esther091/IoT-based-Predictive-Maintenace-of-Li-ion-Batteries-using-Machine-Learning/docs/main_py_Explained.docx

main.py Explained

A line-by-line guide to the backend of the Battery Health Monitor

File: backend/main.py (460 lines) • For: Mgbedo C. E. and Tarurhor J. O.

How to use this guide

Open backend/main.py in VS Code next to this document. Section 1 explains the Python building blocks you will see everywhere (def, if, @decorators, global, class, try). Section 2 walks through the file from top to bottom, quoting the code with its line numbers. Section 3 follows one reading on its journey through the code, and Section 4 lists the possible results of a discharge.

# What main.py does

main.py is the brain of the system. It runs on the laptop as a small web server (the “backend”) and has four jobs:

1. Receive every reading the ESP32 sends (every 5 seconds) and store it in the database.
2. Detect when a discharge starts and ends, collecting the readings in between.
3. Decide whether the finished discharge is valid and, if so, ask the ML models for SOH and RUL.
4. Answer the dashboard’s questions (latest reading, history, predictions, status).

It never talks to the hardware directly. The ESP32 sends it data over WiFi, and the dashboard asks it for data, both using ordinary web requests (HTTP).

# 1. The Python building blocks you will see

## Comments and docstrings

Anything after # is a comment: a note for humans that Python ignores. Text between triple quotes """ ... """ at the top of a file or function is a docstring, a longer description of what that file or function does.

# Rated capacity of ONE cell. <- comment

def charge_mah(buf):

"""Trapezoidal integral of |current|...""" <- docstring

## import – borrowing tools from other files

import brings in code written elsewhere so this file can use it. For example from fastapi import FastAPI borrows the FastAPI tool that turns Python functions into a web server.

## Variables and constants

A variable is a named box that holds a value: is_discharging = False. By convention, names written in CAPITALS are constants: settings that should not change while the program runs, such as DISCHARGE_THRESHOLD = -0.5. Keeping them at the top makes them easy to find and adjust.

## def – defining a function

def creates a function: a named, reusable block of steps. The names in brackets are its inputs (parameters); return sends a result back. A function does nothing until something calls it by name.

def charge_mah(buf): # define a function with one input, buf

... # the steps

return total / 3.6 # the answer it gives back

capacity_mah = charge_mah(buf) # call it and store the answer

Indentation (the spaces at the start of a line) is how Python knows which lines belong to the function. Everything indented under def is part of it.

## if / elif / else – making decisions

if runs its indented lines only when a condition is true. elif (“else if”) checks another condition, and else runs when none of the above were true. Only one branch runs.

if interrupted: # first check

level = "INTERRUPTED"

elif not started_full: # only checked if the first was false

level = "NOT_STARTED_FULL"

else: # none of the above

level = "PARTIAL_DISCHARGE"

Conditions use comparisons like < (less than), <= (less than or equal), >=, == (equal), and words like and, or, not.

## Lists, dictionaries and loops

- A list is an ordered collection: [3.9, 3.8, 3.7]. discharge_buffer is a list of readings.
- A dictionary stores named values: {"voltage": 3.9, "current": -1.4}. Each buffered reading is a dictionary, read with r["voltage"].
- A list comprehension builds a list in one line: voltages = [r["voltage"] for r in buf] means “take the voltage from every reading in buf”.
- sum(...), min(...), max(...), len(...) add up, find the smallest, the largest, and count.

## class – describing a kind of object

A class is a template. In main.py the classes describe the shape of data, for example class ReadingInput(BaseModel) says a reading must have a voltage, current, power and energy, each a number. This uses a library called Pydantic, which automatically checks incoming data against the template and rejects anything that does not fit.

## @decorators – labels that add behaviour

A line starting with @ directly above a def is a decorator. It wraps the function with extra behaviour without changing the function’s own code. Think of it as a label that tells a library what to do with the function. The decorators in main.py:

Decorator | What it means
@app.post("/readings") | “When a POST request arrives at the address /readings, run the function below.” This is how the ESP32’s readings reach receive_reading.
@app.get("/latest") (and /history, /predictions, /health) | “When a GET request arrives at this address, run the function below and send back what it returns.” The dashboard uses these.
@field_validator("voltage") | Pydantic: “run this function to check and tidy the voltage field of every incoming reading.”
@classmethod | Python: the function belongs to the class itself, not to one object. Pydantic requires it on validators.
@asynccontextmanager | Turns lifespan into a start-up/shut-down routine (explained in section 2.2).

## global – changing a shared variable

Variables created at the top of the file (like is_discharging, discharge_buffer, cycle_counter) are shared by all functions. A function can read them freely, but to change one it must say global name first. Without that line, Python would create a separate local copy and the change would be lost when the function ends.

## try / except / finally – handling errors safely

try runs code that might fail. If an error happens, Python jumps to except instead of crashing. finally runs no matter what – perfect for clean-up such as emptying the buffer or closing the database.

try:

...save the cycle and prediction...

except Exception as e:

db.rollback() # undo half-finished database changes

print(f"Error ... {e}")

finally:

discharge_buffer = [] # always start the next discharge empty

## Other small things

- None means “no value” – e.g. a prediction’s SOH is None when no prediction was made.
- True / False are yes / no values (booleans).
- f"...{x}..." is an f-string: text with values inserted, e.g. f"Cycle {cycle_counter} complete". {x:.2f} shows x with 2 decimal places.
- print(...) writes a message in the backend window – this is where you see “Discharge started”, “Cycle 1 complete …” and safety warnings.
- async / yield appear only in lifespan; you do not need them anywhere else in this file.

# 2. The file from top to bottom

## 2.1 Lines 1–20: description and imports

Lines 1–6 are the file’s docstring. Lines 8–20 import the tools it needs:

Import | What it is used for
FastAPI, Depends, HTTPException | Build the web server, hand each request a database session, and report errors.
CORSMiddleware | Allow the dashboard (a different program/port) to call this server.
BaseModel, Field, field_validator, ConfigDict | Pydantic: describe and check the data shapes.
Session, func | SQLAlchemy: talk to the SQLite database; func.max finds the highest cycle number.
datetime, timezone, time | Time stamps (UTC) and the laptop clock in seconds.
List, Optional | Type hints: “a list of …”, “… or None”.
uvicorn | The program that actually runs the web server on port 8000.
from database import ... | Our own database.py: the tables Reading, Cycle, Prediction and session helpers.
from ml_inference import inference | Our own ml_inference.py: the loaded models and their predict() function.

## 2.2 Lines 26–46: lifespan – what happens at start-up

@asynccontextmanager

async def lifespan(app: FastAPI):

global cycle_counter

create_tables() # make sure the database tables exist

inference.load_models() # load the 5 .pkl model files

...find the highest cycle number already in the database...

yield # <- the server runs here, receiving requests

print("Backend shutting down.")

Everything before yield runs once when the backend starts: it prepares the database, loads the machine-learning models (you see “All ML models loaded successfully.”) and recovers the cycle count so numbering continues after a restart. The server then runs at yield until it is closed; the line after yield runs on shut-down.

## 2.3 Lines 49–61: creating the app

app = FastAPI(...) creates the web server object and attaches the lifespan routine. app.add_middleware(CORSMiddleware, allow_origins=["*"], ...) lets any page (in practice, the Streamlit dashboard) call it. Every @app.get / @app.post decorator later in the file registers a function with this app.

## 2.4 Lines 63–93: shared state and settings

Shared state – variables that remember what is happening between readings:

Variable | Meaning
discharge_buffer = [] | The readings collected during the current discharge.
is_discharging = False | Are we in the middle of a discharge right now?
cycle_start_time = None | When the current discharge began.
cycle_counter = 0 | How many discharges have been processed (gives each cycle its number).
last_rx_wall = None | Laptop clock time of the last reading received – used to notice when readings stop.
rest_peak_v = None | Highest resting (no-load) voltage per cell seen while idle – the evidence that the cells were charged.
discharge_rest_v = None | The resting voltage captured when the current discharge started.
load_off_since = None | When the load current first dropped away mid-discharge – used to ignore short dropouts.

Settings (constants) – the numbers that control the decisions:

Constant | Value | Meaning
DISCHARGE_THRESHOLD | −0.5 A | Current below this = discharging. The −0.5 margin ignores sensor noise around 0 A.
RATED_CAPACITY_MAH | 2000 | Capacity of one new cell. Measured SOH = mAh delivered ÷ 2000 × 100.
FULL_DISCHARGE_MAX_CELL_V | 3.2 V | The discharge must reach this per-cell voltage (or lower) to count as complete.
FULL_START_MIN_CELL_V | 3.99 V | The RESTING voltage per cell before the load went on must be at least this – i.e. the cells were charged.
FULL_START_MAX_CELL_V | 4.5 V | …and not above this (a higher value would be an impossible reading).
LOAD_OFF_CONFIRM_SECONDS | 30 s | The load must stay off this long to end a discharge, so a brief contact dropout does not split one run in two.
LOW_CELL_ALARM_V | 2.8 V | Below this, a “SWITCH THE LOAD OFF NOW” warning is printed and shown.
BMS_CUTOFF_WAIT_SECONDS | 30 s | Silence this long after reaching 3.2 V = the BMS has cut off → discharge complete.
STALE_SECONDS | 180 s | Silence this long in the middle of a discharge = interrupted → no prediction.

## 2.5 Lines 96–101: charge_mah() – counting the charge delivered

def charge_mah(buf):

return sum(

(abs(buf[k]["current"]) + abs(buf[k - 1]["current"])) / 2

* max(0.0, buf[k]["t"] - buf[k - 1]["t"])

for k in range(1, len(buf))

) / 3.6

This adds up current × time across the discharge (the trapezoidal rule). For each pair of neighbouring readings it takes their average current and multiplies by the seconds between them, giving amp-seconds. Dividing the total by 3.6 converts amp-seconds into milliamp-hours (mAh). Example: 1.4 A for 60 minutes → 1.4 × 3600 ÷ 3.6 = 1400 mAh. This is the number behind the dashboard’s “Charge delivered” and “Measured SOH”.

## 2.6 Lines 107–183: the data shapes (Pydantic schemas)

Each class describes data coming in or going out.

ReadingInput (lines 107–136) is the shape every ESP32 reading must have. Field(..., gt=0, lt=350) means “required, greater than 0 and less than 350”. If a reading breaks a rule, FastAPI automatically rejects it with error 422 and the code below never sees it. The four @field_validator functions tidy each value: voltage_check rejects voltages below 0.05 V (“check PZEM-017 connections”) and rounds to 3 decimals; the others round current, power and energy.

ReadingOut, PredictionOut, CycleOut, LatestOut (lines 139–183) describe what is sent back to the dashboard. model_config = ConfigDict(from_attributes=True) lets Pydantic build them straight from database rows. Optional[float] means “a number, or None” – SOH is None when no prediction was made. CycleOut.measured_soh is filled in by /latest.

## 2.7 Lines 186–296: process_discharge_cycle() – the heart of the file

Called once when a discharge ends. It turns the buffered readings into one cycle and, if the cycle is valid, a prediction. Step by step:

1. Too short? (lines 192–194) Fewer than 3 readings is a blip, not a discharge: empty the buffer and stop.
2. Sort the readings by device time (line 198), in case some arrived late from the ESP32’s memory.
3. Compute the four model inputs (lines 199–216), exactly as in training: mean voltage, mean |current| (always positive), mean power, and energy delivered in Wh (V × |I| × time, trapezoidal rule ÷ 3600).
4. Measure and check (lines 218–226): capacity_mah via charge_mah(); min_cell_voltage (did it reach empty?); start_cell_voltage = the resting voltage recorded before the load went on (if none was received, the highest of the first 6 readings). Then complete = reached ≤ 3.2 V **and** started at 3.99–4.5 V **and** not interrupted.
5. Save the cycle (lines 228–243): increase cycle_counter and add a Cycle row with the features, mAh, minimum voltage and the complete flag.
6. Predict or explain (lines 245–258): if complete, call inference.predict(...) – this is where Random Forest and XGBoost produce SOH, RUL and the alert level. Otherwise create an empty result whose alert_level says why: INTERRUPTED, NOT_STARTED_FULL or PARTIAL_DISCHARGE.
7. Save the prediction (lines 260–271) as a Prediction row and commit (make the database changes permanent).
8. Print a summary in the backend window (lines 273–288), e.g. “Cycle 3 complete -- SOH: 92.1% … delivered 1840 mAh (measured SOH 92.0%)”.
9. If anything failed (lines 290–293): undo the database changes and the cycle number. Always (lines 295–296): empty the buffer for the next discharge.

The interrupted=False and start_rest_v=None in the first line are default values: callers can leave them out. interrupted is only True when close_if_stale() decides the readings stopped too early, and start_rest_v carries the resting voltage measured before the load went on.

## 2.8 Lines 302–367: receive_reading() – the /readings address

@app.post("/readings") makes this run for every reading the ESP32 sends. data: ReadingInput means FastAPI has already checked the reading against the ReadingInput shape. db: Session = Depends(get_db) means FastAPI opens a database session for this request and closes it afterwards.

1. Check for a stale discharge first (line 309): if readings had stopped for too long, close that old run before handling the new reading – so a new test is never glued onto a broken one. Then note the time (line 310).
2. Store the reading in the readings table (lines 312–324). If saving fails, reply with error 500.
3. Make a small dictionary of the reading for the buffer (lines 326–334). The time t comes from the ESP32’s own clock (milliseconds ÷ 1000), so readings cached during a WiFi drop keep their real spacing.
4. Safety check (lines 336–338): discharging and below 2.8 V per cell → print the SWITCH OFF warning.
5. The discharge detector (lines 340–365) – a small “state machine”:
  - Current below −0.5 A and not already discharging → a discharge has started: set is_discharging = True, note the start time, empty the buffer, and keep the resting voltage seen just before (discharge_rest_v). Every discharging reading is then appended to the buffer.
  - Current back above −0.5 A while discharging → the load may be off: note the time in load_off_since. Only if it stays off for 30 s does end_discharge(db) close the run; if current returns sooner (a loose contact), the same discharge simply continues. With no load at all, each reading updates rest_peak_v, the resting voltage.
6. Reply {"status": "ok", "id": ...} so the ESP32 knows the reading arrived (line 367).

## 2.9 Lines 370–392: the dashboard’s read-only addresses

Address | Function | What it returns
GET /latest | get_latest | The newest reading, newest prediction and newest cycle (plus measured SOH = mAh ÷ 2000 × 100). Feeds the cards, gauge, banners and result row.
GET /history?limit=100 | get_history | The last 100 readings, oldest first. Feeds the four charts and the Raw Readings table.
GET /predictions | get_predictions | Every prediction ever made, oldest first.

response_model=LatestOut (etc.) tells FastAPI to shape the reply using that Pydantic class. .order_by(Reading.id.desc()).first() means “sort newest first and take the first one”.

## 2.10 Lines 394–432: end_discharge() and close_if_stale() – when a run ends

On the rig, the PZEM-017 gets its power through the BMS output, so when the BMS cuts off at the end of a discharge the PZEM goes silent and the final “0 A” reading never arrives. This function handles that:

if load off for 30 s: # load switched off and stayed off

end_discharge(db) # -> closes the run normally

silent = time.time() - last_rx_wall # seconds since the last reading

reached_end = min(voltages in buffer) <= 3.2 # had the pack reached empty?

if reached_end and silent > 30: # BMS cut-off

process_discharge_cycle(db) # -> complete, predict

elif silent > 180: # stopped too early

process_discharge_cycle(db, interrupted=True) # -> INTERRUPTED, no prediction

It is called both when a new reading arrives and every time the dashboard checks /health (every 5 s), so a cut-off is noticed even though no more readings come.

## 2.11 Lines 434–457: health_check() – the /health address

Called by the dashboard every 5 seconds. It first runs close_if_stale() (with its own database session, opened and closed with try/finally), then returns the live status: seconds since the last reading, whether models are loaded, whether a discharge is running, the cycle count, and the live progress (discharge_mah, discharge_minutes) shown in the blue “Discharging …” banner.

## 2.12 Lines 459–460: starting the server

if __name__ == "__main__":

uvicorn.run("main:app", host="0.0.0.0", port=8000, reload=False)

if __name__ == "__main__": is true only when the file is run directly (python main.py, which start_system.bat does). It starts the server on port 8000, listening on all network addresses (0.0.0.0) so the ESP32 on the WiFi can reach it.

# 3. One reading’s journey

1. The ESP32 sends {"voltage": 3.95, "current": -1.42, "power": 5.6, "energy": 0.3, "timestamp": 812345} to http://<laptop-IP>:8000/readings.
2. FastAPI checks it against ReadingInput (all numbers in range? voltage ≥ 0.05?). If not → error 422.
3. receive_reading() runs: checks for a stale run, saves the reading to the database, adds it to the buffer (current is below −0.5 A, so it is part of a discharge).
4. Five seconds later the dashboard calls /latest, /history and /health and shows the new values.
5. About 80 minutes later the BMS cuts off. Readings stop. Within ~30 s close_if_stale() (via /health) sees the pack had reached ≤ 3.2 V and calls process_discharge_cycle().
6. The resting voltage before the load was 3.99–4.5 V and the pack reached ≤ 3.2 V → complete → inference.predict() → SOH, RUL, alert saved → shown on the dashboard.

# 4. How a discharge is classified

Result (alert_level) | When | Prediction? | Dashboard banner
NORMAL / WARNING / CRITICAL / URGENT | Rested at 3.99–4.5 V/cell before the load, reached ≤ 3.2 V/cell, not interrupted | Yes | Coloured alert + SOH gauge, RUL, result row
NOT_STARTED_FULL | Resting voltage before the load outside 3.99–4.5 V/cell (cells not charged) | No | Did not start from a full pack
PARTIAL_DISCHARGE | Started full, but the load was switched off (for 30 s or more) before 3.2 V/cell | No | Partial discharge
INTERRUPTED | Readings stopped for 3 min before reaching 3.2 V/cell | No | Discharge interrupted
(fewer than 3 readings) | A blip, not a discharge | No | Nothing recorded

The alert levels for a valid prediction come from ml_inference.py, based on the predicted RUL: URGENT ≤ 7 days, CRITICAL ≤ 15, WARNING ≤ 30, otherwise NORMAL.

# 5. Glossary

Term | Meaning
Backend | The program running on the laptop that receives, stores and processes data (this file).
Endpoint / address | A URL path the server answers, e.g. /readings or /health.
GET / POST | Two kinds of web request: GET asks for data, POST sends data.
HTTP status 200 / 422 / 500 | OK / the data was invalid / the server hit an error.
Buffer | The list of readings collected during one discharge.
Cycle | One complete or attempted discharge, stored as a row in the cycles table.
Session (database) | A short connection to the database used to read or write rows; always closed afterwards.
commit / rollback | Make database changes permanent / undo them.
Trapezoidal rule | Adding up a quantity over time by averaging neighbouring readings and multiplying by the time gap.
Inference | Using the trained models to make a prediction.

main.py Explained • page 9
