esther091/IoT-based-Predictive-Maintenace-of-Li-ion-Batteries-using-Machine-Learning/docs/Full_circuit_diagram.png

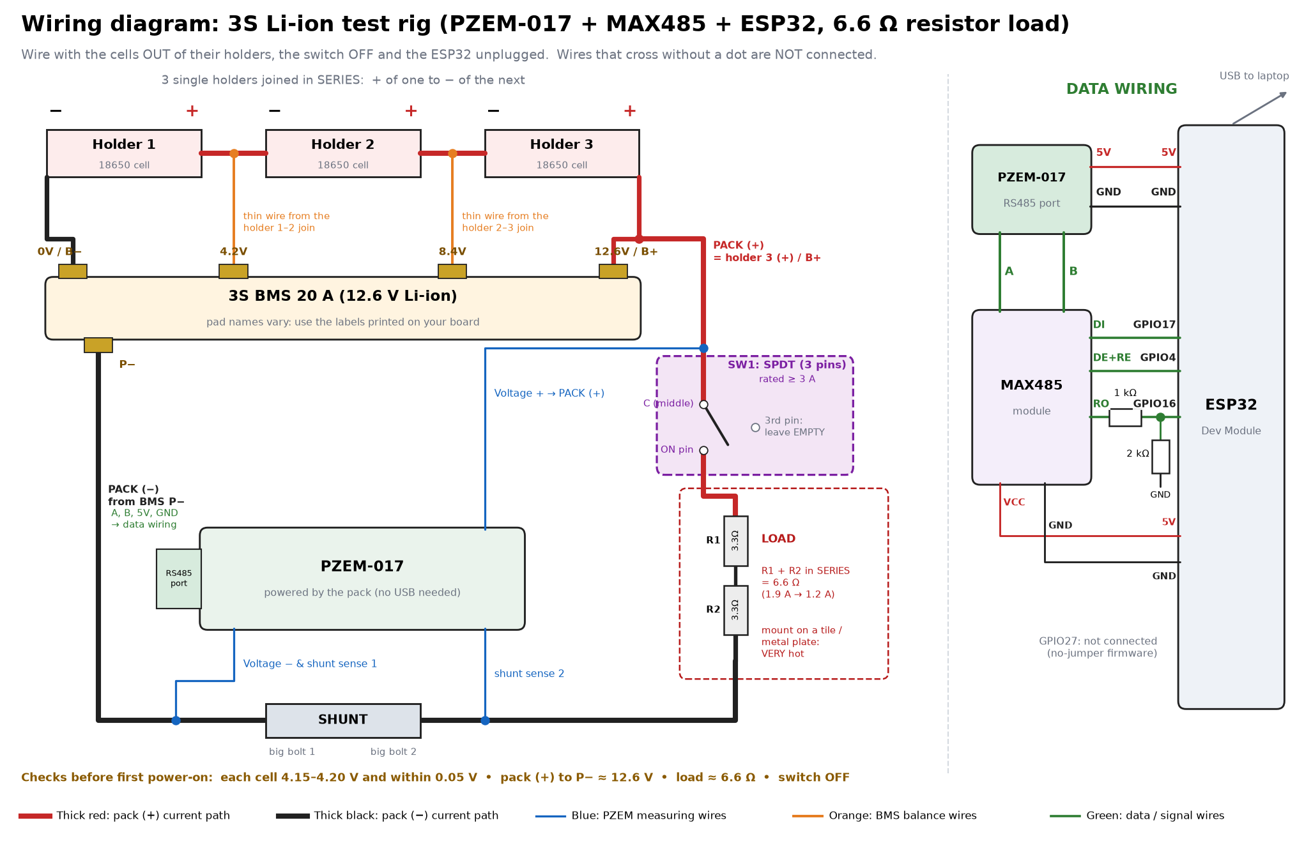
docs/Full_circuit_diagram.png
