esther091/IoT-based-Predictive-Maintenace-of-Li-ion-Batteries-using-Machine-Learning/docs/PZEM_connection_closeup.png

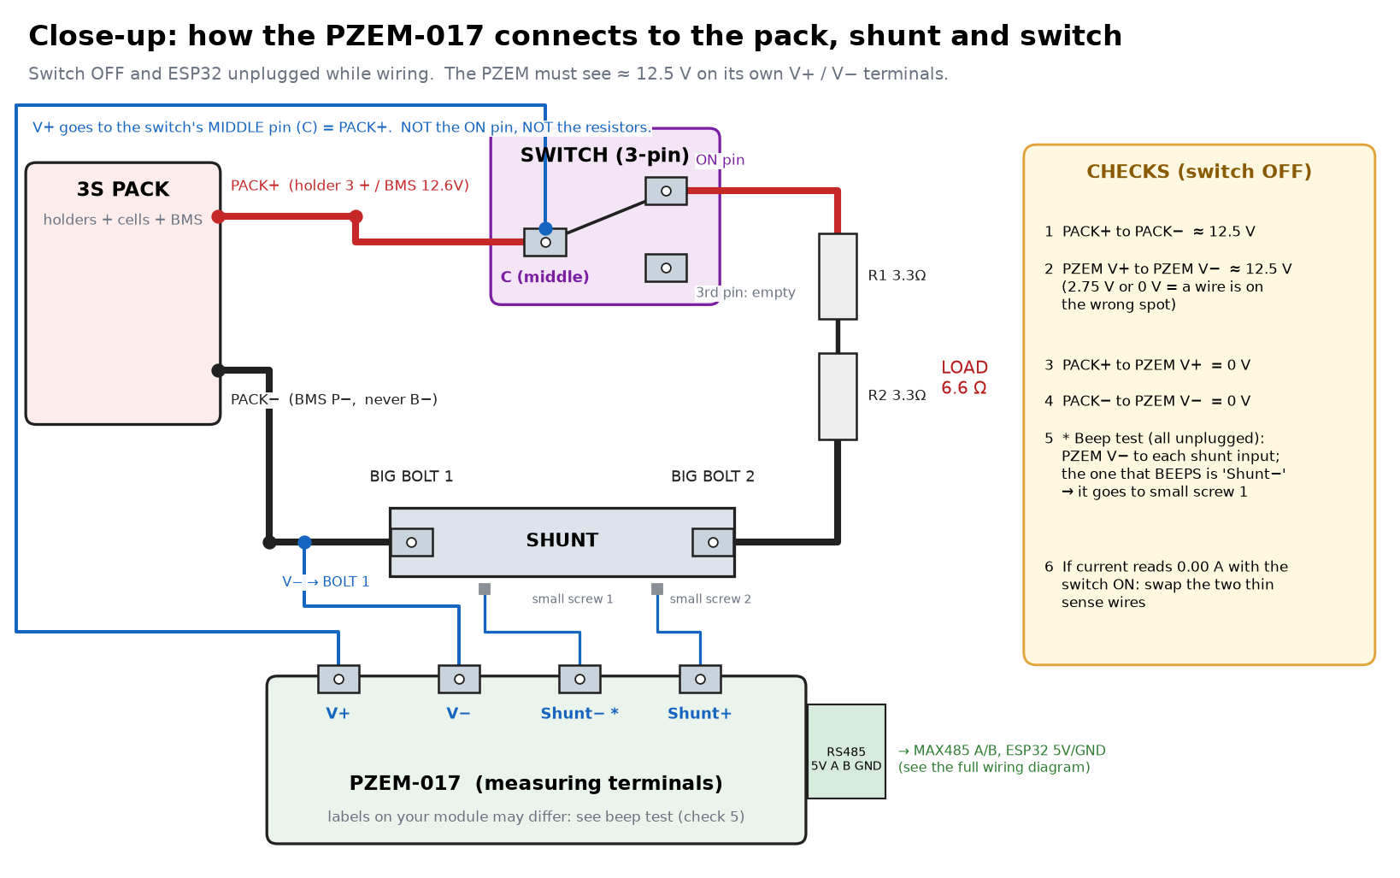
docs/PZEM_connection_closeup.png
