esther091/IoT-based-Predictive-Maintenace-of-Li-ion-Batteries-using-Machine-Learning/docs/Schematic_diagram.png

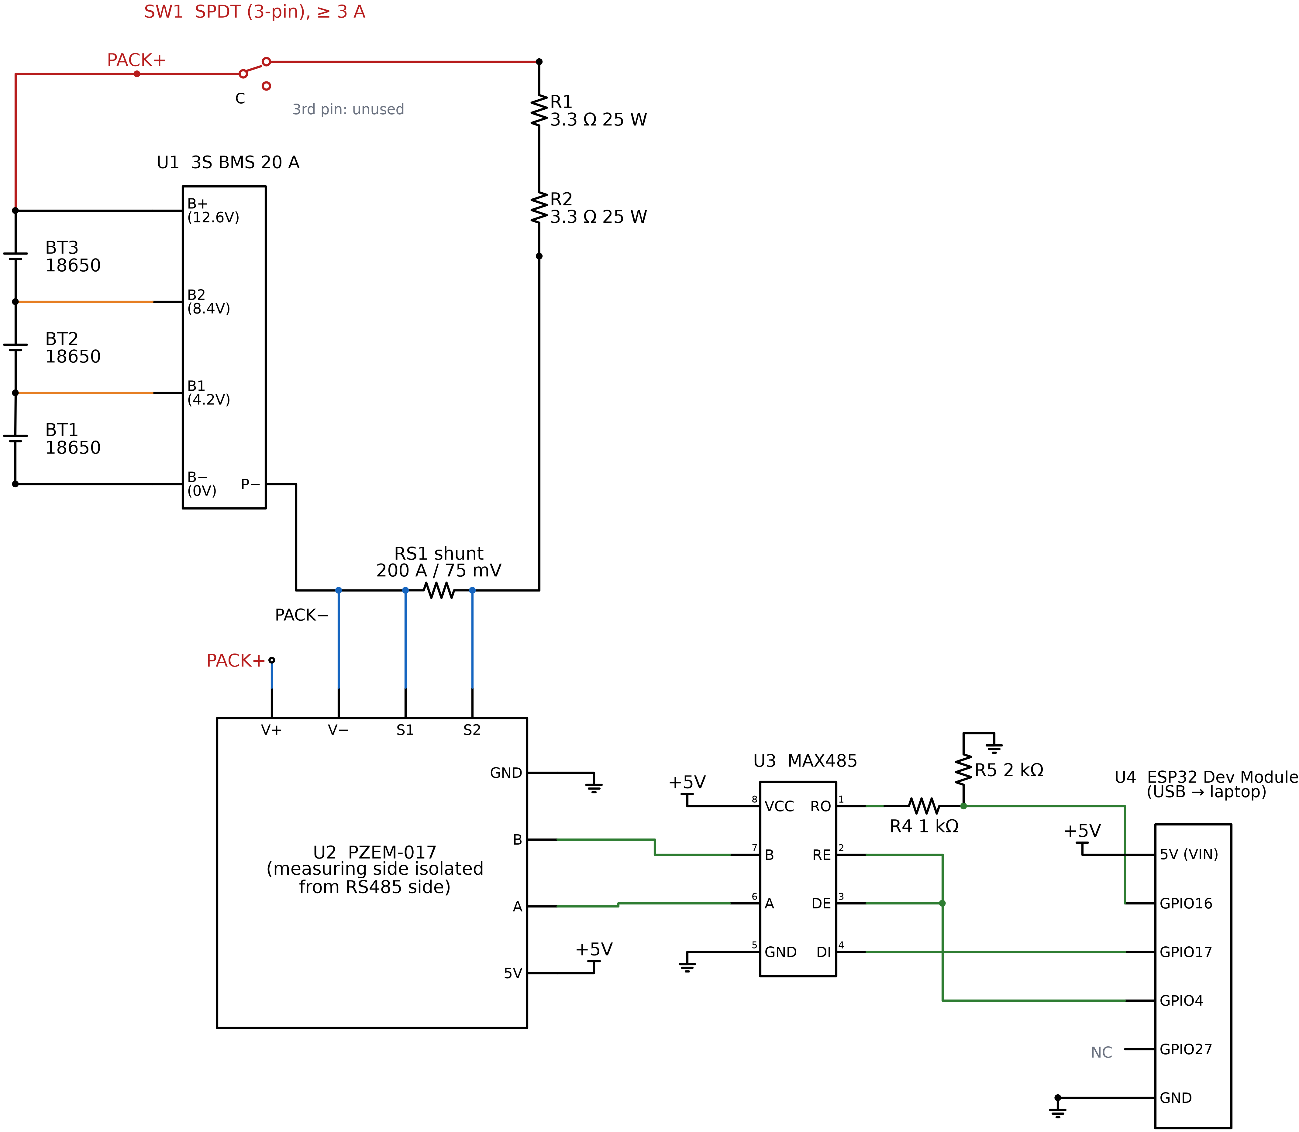
docs/Schematic_diagram.png
