esther091/IoT-based-Predictive-Maintenace-of-Li-ion-Batteries-using-Machine-Learning/report_results/fig_4_4_rul_pred_vs_actual.png

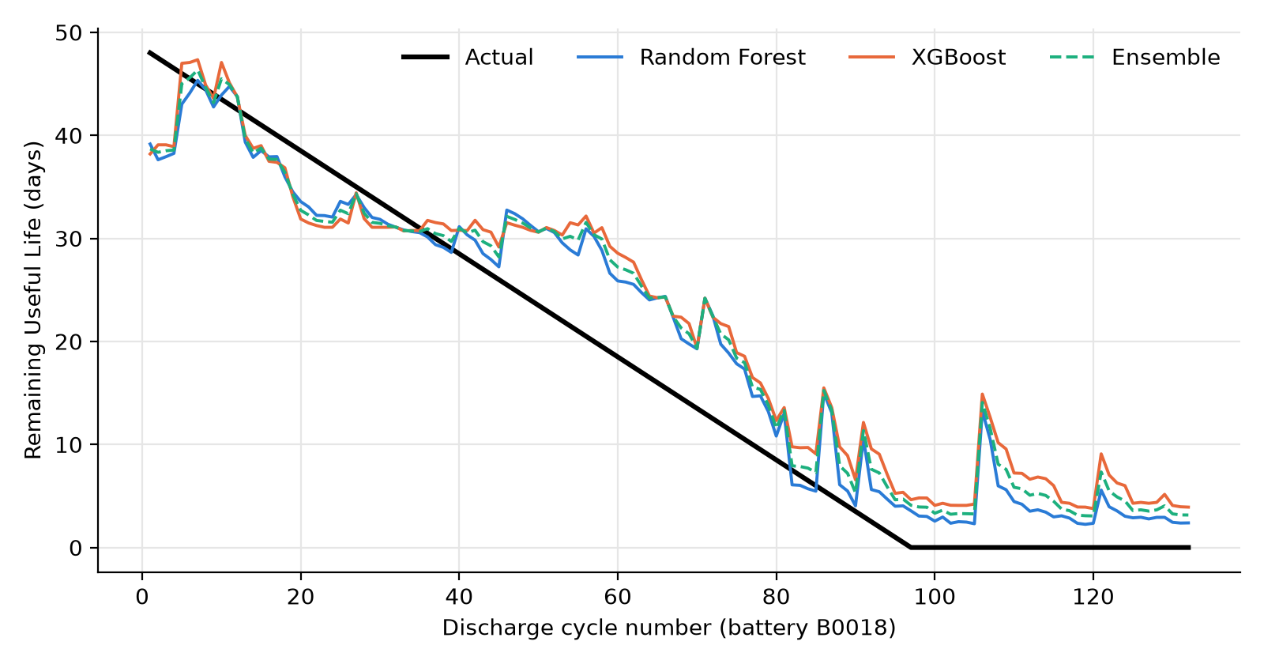
report_results/fig_4_4_rul_pred_vs_actual.png
