esther091/IoT-based-Predictive-Maintenace-of-Li-ion-Batteries-using-Machine-Learning/report_results/fig_4_5_model_r2.png

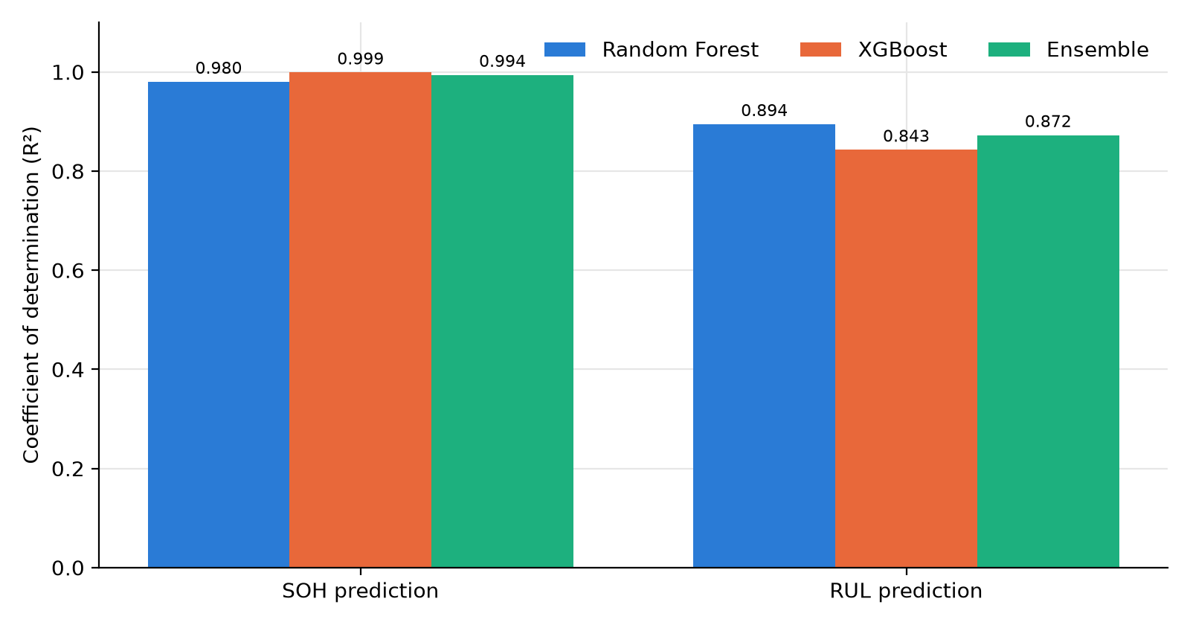
report_results/fig_4_5_model_r2.png
