esther091/IoT-based-Predictive-Maintenace-of-Li-ion-Batteries-using-Machine-Learning/report_results/fig_4_6_feature_importance.png

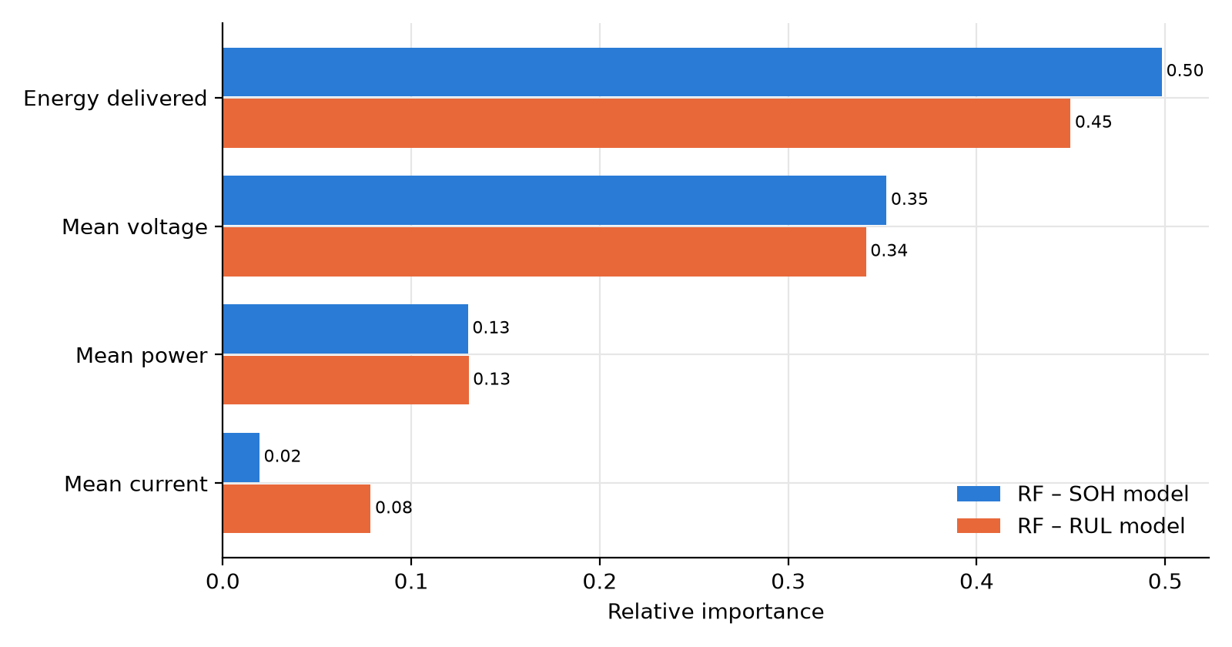
report_results/fig_4_6_feature_importance.png
