esther091/IoT-based-Predictive-Maintenace-of-Li-ion-Batteries-using-Machine-Learning/(commit log)

2026-10-11 IoT-based predictive maintenance of Li-ion batteries
    ESP32 + PZEM-017 sensing of a 3S 18650 pack, FastAPI backend with
    discharge-cycle detection and validity checks, Random Forest + XGBoost
    SOH/RUL models trained on the NASA PCoE dataset, and a Streamlit
    dashboard. WiFi credentials are kept in an untracked secrets.h.
2026-10-19 Retrain without feature scaling, tune by leave-one-battery-out CV
    - Use the raw cycle features directly; tree models are not affected by
    scaling, so the Min-Max scaler is removed from training and the backend.
    - Train on B0005, B0006 and B0007 and tune hyperparameters by
    leave-one-battery-out cross-validation; B0018 stays unseen as the test
    battery. Evaluation models are saved in ml/models/eval/.
    - Retrain the final models on all four batteries for the backend.
    - report_results.py: report from the evaluation models, add the
    leave-one-battery-out table and the replay reference predictions.
    - Regenerate the Chapter 4 tables and figures.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
2026-10-19 Add the NASA data files and the processed dataset
    - Include the four NASA battery files (B0005, B0006, B0007, B0018) in
    ml/data, so the training can be reproduced from the repository alone.
    - Add ml/data/processed_cycles.csv: the 602 cycles kept after outlier
    removal, with their four features, measured capacity, SOH and RUL.
    - Add tools/export_dataset.py, which regenerates the CSV.
    [processed_cycles.csv]
2026-10-20 Reject readings whose power does not match voltage x current
